olofos/humidity/humidity.ods

Sheet: Power
 | Sleep | Measure | Transmit | Receive | Total
STM32L031F6P6 @ 16MHz | 0.02 | 4.8 | 4.8 | 4.8
RFM69HW | 0.005 | 0.005 | 50 | 16
SHTC3 | 0.001 | 0.9 | 0.001 | 0.001
 | 0.026 | 5.705 | 54.801 | 20.801
Time (s/h) | 3565 | 15 | 10 | 10 | 3600
mAs/h | 92.69 | 85.575 | 548.01 | 208.01
mAh/h | 0.025747222222222 | 0.023770833333333 | 0.152225 | 0.057780555555556 | 0.259523611111111
Battery (mAh) |  |  |  |  | 600
Runtime (y) |  |  |  |  | 0.263918764044968

Sheet: Pins
 | Function | Signal | TQFP32
VDD |  |  | 1
PC14 | OSC32_IN |  | 2
PC15 | OSC32_OUT |  | 3
NRST |  |  | 4
VDDA |  |  | 5
PA0-CK_IN |  | LEDR | 6
PA1 |  | LEDH | 7
PA2 | USART2_TX |  | 8
PA3 | USART2_RX |  | 9
PA4 | ADC | BAT_MID | 10
PA5 | SPI1_SCK |  | 11
PA6 | SPI1_MSIO |  | 12
PA7 | SPI1_MISO |  | 13
PB0 |  | CS_RFM | 14
PB1 |  | CS_FLASH | 15
VSS |  |  | 16
VDD |  |  | 17
PA8 |  | RFM69_INT | 18
PA9 | I2C1_SCL |  | 19
PA10 | I2C1_SDA |  | 20
PA11 |  | - | 21
PA12 |  | - | 22
PA13 | SWDIO |  | 23
PA14 | SWCLK |  | 24
PA15 |  | - | 25
PB3 |  | CONF0 | 26
PB4 |  | CONF1 | 27
PB5 |  | CONF2 | 28
PB6 |  | CONF3 | 29
PB7 |  | CONF4 | 30
BOOT0 |  |  | 31
VSS |  |  | 32

Sheet: BOM
Node
 | Qty | Reference(s) | Value | TME Link | TME Price | Sum |  | 5
 | 7 | C1, C2, C3, C4, C6, C7, C14 | 100n | https://www.tme.eu/se/en/details/cl10b104ko8nnnc/0603-mlcc-smd-capacitors/samsung/ | 0.13310 | 0.93 | x | 35
 | 2 | C5, C15 | 22u | https://www.tme.eu/se/en/details/sc1e226m05005vr/85degc-smd-electrolytic-capacitors/samwha/ | 0.36794 | 0.74 | x | 10 | https://www.tme.eu/se/en/details/uwx1c220mcl1gb/85degc-smd-electrolytic-capacitors/nichicon/
 | 2 | C12, C13 | 18p | https://www.tme.eu/se/en/details/vj0603a180jxacw2bc/0603-mlcc-smd-capacitors/vishay/ | 0.13033 | 0.26 | x | 10
 | 1 | D1 | KP-2012LSURCK | https://www.tme.eu/se/en/details/kp-2012lsurck/smd-colour-leds/kingbright-electronic/ | 1.02540 | 1.03 | x | 5
 | 1 | D2 | KP-2012LSGC | https://www.tme.eu/se/en/details/kp-2012lsgc/smd-colour-leds/kingbright-electronic/ | 1.05200 | 1.05 | x | 5
 | 1 | D3 | 1N4148W | https://www.tme.eu/se/en/details/1n4148w-7-f/smd-universal-diodes/diodes-incorporated/ | 0.24810 | 0.25 | x | 5
 | 1 | J1 | BOOT0_Jumper |  |  | 0.00 |  | 5
 | 1 | J2 | FTDI |  |  | 0.00 |  | 5
 | 1 | J3 | SMA Female | https://www.tme.eu/se/en/details/rf2-03e-t-00-50-g/sma-smb-smc-connectors/adam-tech/ | 12.76000 | 12.76 | x | 5
 | 1 | J4 | 2 x AA | https://www.tme.eu/se/en/details/zl262-3sg/pin-headers/connfly/ds1023-1-3s21/ | 0.60822 | 0.61 | x | 5
 | 1 | J5 | SWD |  |  | 0.00 |  | 5
 | 1 | Q1 | Si2323DDS | https://www.tme.eu/se/en/details/si2323dds-t1-ge3/smd-p-channel-transistors/vishay/ | 3.34344 | 3.34 | x | 5
 | 5 | R1, R2, R3, R4, R5 | 0 | https://www.tme.eu/se/en/details/smd0603-0r/0603-smd-resistors/royal-ohm/0603saj0000t5e/ | 0.09735 | 0.49 | x | 25
 | 2 | R11, R12 | DNP | - |  | 0.00 |  | 10
 | 3 | R13, R32, R33 | 10k | https://www.tme.eu/se/en/details/crcw060310k0fktabc/0603-smd-resistors/vishay/ | 0.12458 | 0.37 | x | 15
 | 3 | R14, R16, R30 | 330R | https://www.tme.eu/se/en/details/smd0603-330r-1%25/0603-smd-resistors/royal-ohm/0603saf3300t5e/ | 0.11531 | 0.35 | x | 15
 | 5 | R17, R20, R21, R25, R34 | 100k | https://www.tme.eu/se/en/details/cq0603-100k-1%25/0603-smd-resistors/royal-ohm/cq03saf1003t5e/ | 0.18525 | 0.93 | x | 25
 | 2 | R18, R19 | 4k7 | https://www.tme.eu/se/en/details/smd0603-4k7-1%25/0603-smd-resistors/royal-ohm/0603saf4701t5e/ | 0.11513 | 0.23 | x | 10
 | 1 | R31 | 240R | https://www.tme.eu/se/en/details/smd0603-240r-1%25/0603-smd-resistors/royal-ohm/0603saf0241t5e/ | 0.11531 | 0.12 | x | 5
 | 1 | SW1 | DTSM-65R-V-B | https://www.tme.eu/se/en/details/dtsm-65r-v-b/microswitches-tact/diptronics/ | 1.88940 | 1.89 | x | 5
 | 1 | U1 | RFM69HW | https://www.tme.eu/se/en/details/rfm69hw-433s2/rf-modules/hope-microelectronics/ | 29.96000 | 29.96 | x | 5
 | 1 | U2 | SHTC3 | https://www.tme.eu/se/en/details/shtc3/humidity-sensors/sensirion/3-000-047/ | 16.93000 | 16.93 | x | 5
 | 1 | U3 | AT25DF512C | https://www.tme.eu/se/en/details/at25df512c-sshngub/serial-flash-memories-integrated-circ/adesto/at25df512c-sshngu-b/ | 4.54000 | 4.54 | x | 5
 | 1 | U4 | STM32L031K6T6 | https://www.tme.eu/se/en/details/stm32l031k6t6/st-microcontrollers/st-microelectronics/ | 20.98000 | 20.98 | x | 5
 | 1 | Y1 | 32.768K | https://www.tme.eu/se/en/details/26-hx5f-32.768k/tht-quartz-crystals/ilsi/26-hx5f12-5-32-768khz/ | 1.52097 | 1.52 | x | 5
 |  |  |  |  | Total | 99.26
Node Batteries
 | Qty | Reference(s) | Value | TME Link | TME Price | Sum
 | 2 | BT1, BT2 | Battery_Cell | https://www.tme.eu/se/en/details/bh-311-1p/batteries-holders/comf/ | 2.56888 | 5.14 | x | 10
 | 1 | J1 | Conn_01x03_Male | https://www.tme.eu/se/en/details/zl201-03g/pin-headers/connfly/ds1021-1-3sf1-1/ | 0.22041 | 0.22 | x | 5
 |  |  |  |  | Total | 5.35817
Case
 | 1 | Antenna | 433M-ANT402 | https://www.tme.eu/se/en/details/433m-ant402/rf-antennas/sr-passives/ | 22.12000 | 22.12 | x
 | 4 | Standoff M3 6mm | TFM-M3X6/DR214 | https://www.tme.eu/se/en/details/tfm-m3x6_dr214/metal-spacers/dremec/214x06/ | 2.85150 | 11.41
 | 4 | Standoff M3 12mm | TFM-M3X12/DR224 | https://www.tme.eu/se/en/details/tfm-m3x12_dr224/metal-spacers/dremec/224x12/ | 2.24350 | 8.97
 | 4 | Standoff M3 15mm | TFM-M3X15/DR224 | https://www.tme.eu/se/en/details/tfm-m3x15_dr224/metal-spacers/dremec/224x15/ | 1.80060 | 7.20
 | 2 | Standoff M3 20mm | TFM-M3X20/DR224 | https://www.tme.eu/se/en/details/tfm-m3x20_dr224/metal-spacers/dremec/224x20/ | 2.50120 | 5.00
 | 2 | Screw M3 8mm | M3X8/D912-A2 | https://www.tme.eu/se/en/details/m3x8_d912-a2/bolts/kraftberg/ | 0.13100 | 0.26
 | 4 | Washer M3 7mm 0.5mm | K3.2/D125-A2 | https://www.tme.eu/se/en/details/k3.2_d125-a2/washers/kraftberg/ | 0.04880 | 0.20
 | 6 | Nut M3 | B3/BN117 | https://www.tme.eu/se/en/details/b3_bn117/nuts/bossard/1874659/ | 0.05111 | 0.31
 | 4 | Foot M3 | RI-TB-3 | https://www.tme.eu/se/en/details/ri-tb-3/feet/richco/tb-3/ | 4.80580 | 19.22
 |  |  |  |  | Total | 74.69
 |  |  |  |  | Sum Total | 179.31
Gateway
 | Qty | Reference(s) | Value | TME Link | TME Price
 | 1 | BT1 | KEYS3000 | https://www.tme.eu/se/en/details/keys3000/batteries-holders/keystone/3000/ | 4.2504 | 4.25 | x
 | 2 | C1, C4 | 22u | https://www.tme.eu/se/en/details/sc1e226m05005vr/85degc-smd-electrolytic-capacitors/samwha/ | 0.36794 | 0.74 | x
 | 2 | C2, C3 | 100n | https://www.tme.eu/se/en/details/cl10b104ko8nnnc/0603-mlcc-smd-capacitors/samsung/ | 0.1331 | 0.27 | x
 | 1 | C6 | 1u |  |  | 0.00
 | 1 | D1 | KP-2012LSURCK | https://www.tme.eu/se/en/details/kp-2012lsurck/smd-colour-leds/kingbright-electronic/ | 1.052 | 1.05 | x
 | 1 | D2 | KP-2012LSGC | https://www.tme.eu/se/en/details/kp-2012lsgc/smd-colour-leds/kingbright-electronic/ | 0.2481 | 0.25 | x
 | 4 | H1, H2, H3, H4 | MountingHole |  |  | 0.00
 | 1 | J1 | FTDI |  |  | 0.00
 | 1 | J2 | Conn_Coaxial | https://www.tme.eu/se/en/details/rf2-19a-t-00-50-g/sma-smb-smc-connectors/adam-tech/ | 10.86 | 10.86 | x
 | 1 | J3 | Raspberry_Pi_2_3 | https://www.tme.eu/se/en/details/zl264-40dg/pin-headers/ninigi/ | 24.27 | 24.27 | x | https://www.tme.eu/se/en/details/zl301-2x20p/pin-headers/ninigi/
 | 4 | R1, R4, R12, R13 | DNP |  |  | 0.00
 | 2 | R2, R3 | 0 | https://www.tme.eu/se/en/details/smd0603-0r/0603-smd-resistors/royal-ohm/0603saj0000t5e/ | 0.09735 | 0.19 | x
 | 2 | R5, R6 | 10k | https://www.tme.eu/se/en/details/crcw060310k0fktabc/0603-smd-resistors/vishay/ | 0.12458 | 0.25 | x
 | 2 | R8, R11 | 330R | https://www.tme.eu/se/en/details/smd0603-330r-1%25/0603-smd-resistors/royal-ohm/0603saf3300t5e/ | 0.11531 | 0.23 | x
 | 1 | U1 | RFM69HW | https://www.tme.eu/se/en/details/rfm69hw-433s2/rf-modules/hope-microelectronics/ | 29.94 | 29.94 | x
 | 1 | U2 | DS1307Z+ | https://www.tme.eu/se/en/details/ds1307z+/rtc-circuits/maxim-integrated/ | 15.02 | 15.02 | x
 | 1 | U3 | AP130-xxY | https://www.tme.eu/se/en/details/ap130-33yg-13/ldo-unregulated-voltage-regulators/diodes-incorporated/ | 2.47293 | 2.47 | x
 | 1 | Y1 | 32768 | https://www.tme.eu/se/en/details/26-hx5f-32.768k/tht-quartz-crystals/ilsi/26-hx5f12-5-32-768khz/ | 1.52097 | 1.52 | x
 |  |  |  |  | Total | 91.31
