olofos/humidity/hardware/gateway/gateway.kicad_pcb

## KiCad design hardware/gateway/gateway.kicad_pcb (2019-08-25)

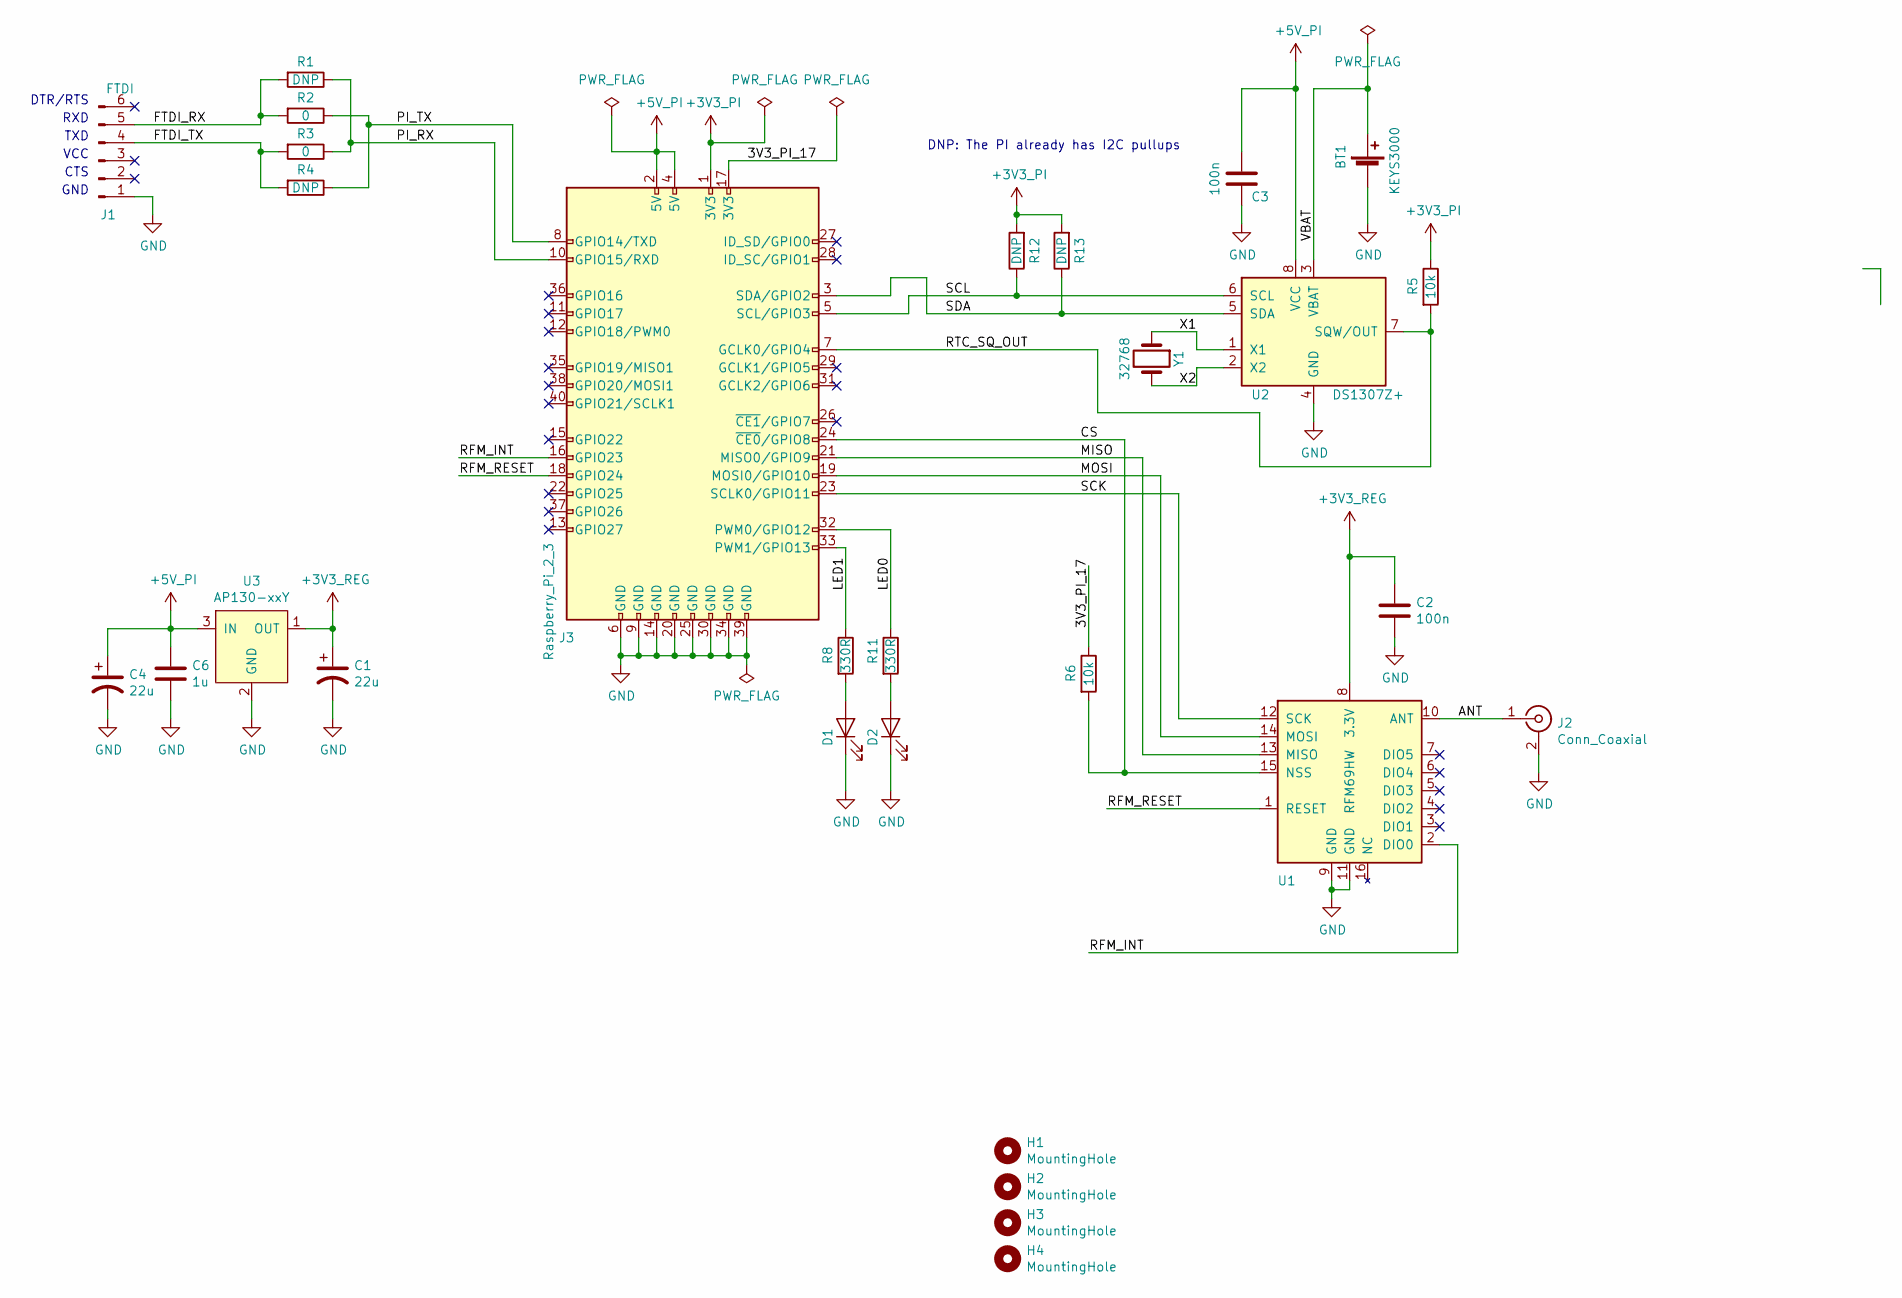
[picture p1: schematic gateway.sch]

Parts:
BT1: KEYS3000; CR1216_Keystone_3000
C1, C4: 22u; CP_Elec_5x5.3
C2, C3: 100n; C_0603_1608Metric_Pad1.05x0.95mm_HandSolder
C6: 1u; C_0805_2012Metric_Pad1.15x1.40mm_HandSolder
D1: KP-2012LSURCK; LED_0805_2012Metric_Pad1.15x1.40mm_HandSolder
D2: KP-2012LSGC; LED_0805_2012Metric_Pad1.15x1.40mm_HandSolder
H1, H2, H3, H4: MountingHole; MountingHole_2.7mm_M2.5
J1: FTDI; PinHeader_1x06_P2.54mm_Horizontal
J2: Conn_Coaxial; Adam_Tech_SMA_Female_RF2-19A
J3: Raspberry_Pi_2_3; PinSocket_2x20_P2.54mm_Vertical_SMD
R1, R4, R12, R13: DNP; R_0603_1608Metric_Pad1.05x0.95mm_HandSolder-DNP
R2, R3: 0; R_0603_1608Metric_Pad1.05x0.95mm_HandSolder
R5, R6: 10k; R_0603_1608Metric_Pad1.05x0.95mm_HandSolder
R8, R11: 330R; R_0603_1608Metric_Pad1.05x0.95mm_HandSolder
U1: RFM69HW
U2: DS1307Z+; SOIC-8_3.9x4.9mm_P1.27mm
U3: AP130-xxY; SOT-89-3_Handsoldering
Y1: 32768; Crystal_C26-LF_D2.1mm_L6.5mm_Horizontal

Connections:
+3V3_PI: J3.1 (3V3), R5.1, R12.2, R13.2
+3V3_REG: C1.1, C2.1, U1.8 (3.3V), U3.1 (OUT)
+5V_PI: C3.1, C4.1, C6.1, J3.2 (5V), J3.4 (5V), U2.8 (VCC), U3.3 (IN)
/3V3_PI_17: J3.17 (3V3), R6.1
/ANT: J2.1 (In), U1.10 (ANT)
/CS: J3.24 (~CE0~/GPIO8), R6.2, U1.15 (NSS)
/FTDI_RX: J1.5, R1.2, R2.2
/FTDI_TX: J1.4, R3.2, R4.2
/LED0: J3.32 (PWM0/GPIO12), R11.1
/LED1: J3.33 (PWM1/GPIO13), R8.1
/MISO: J3.21 (MISO0/GPIO9), U1.13 (MISO)
/MOSI: J3.19 (MOSI0/GPIO10), U1.14 (MOSI)
/PI_RX: J3.10 (GPIO15/RXD), R1.1, R3.1
/PI_TX: J3.8 (GPIO14/TXD), R2.1, R4.1
/RFM_INT: J3.16 (GPIO23), U1.2 (DIO0)
/RFM_RESET: J3.18 (GPIO24), U1.1 (RESET)
/RTC_SQ_OUT: J3.7 (GCLK0/GPIO4), R5.2, U2.7 (SQW/OUT)
/SCK: J3.23 (SCLK0/GPIO11), U1.12 (SCK)
/SCL: J3.5 (SCL/GPIO3), R12.1, U2.6 (SCL)
/SDA: J3.3 (SDA/GPIO2), R13.1, U2.5 (SDA)
/VBAT: BT1.1 (+), U2.3 (VBAT)
/X1: U2.1 (X1), Y1.1
/X2: U2.2 (X2), Y1.2
GND: BT1.2 (-), C1.2, C2.2, C3.2, C4.2, C6.2, D1.1 (K), D2.1 (K), J1.1, J2.2 (Ext), J3.6 (GND), J3.9 (GND), J3.14 (GND), J3.20 (GND), J3.25 (GND), J3.30 (GND), J3.34 (GND), J3.39 (GND), U1.9 (GND), U1.11 (GND), U2.4 (GND), U3.2 (GND)
unnamed: D1.2 (A), R8.2
unnamed: D2.2 (A), R11.2

Notes on the sheet:
GND
CTS
VCC
TXD
RXD
DTR/RTS
DNP: The PI already has I2C pullups

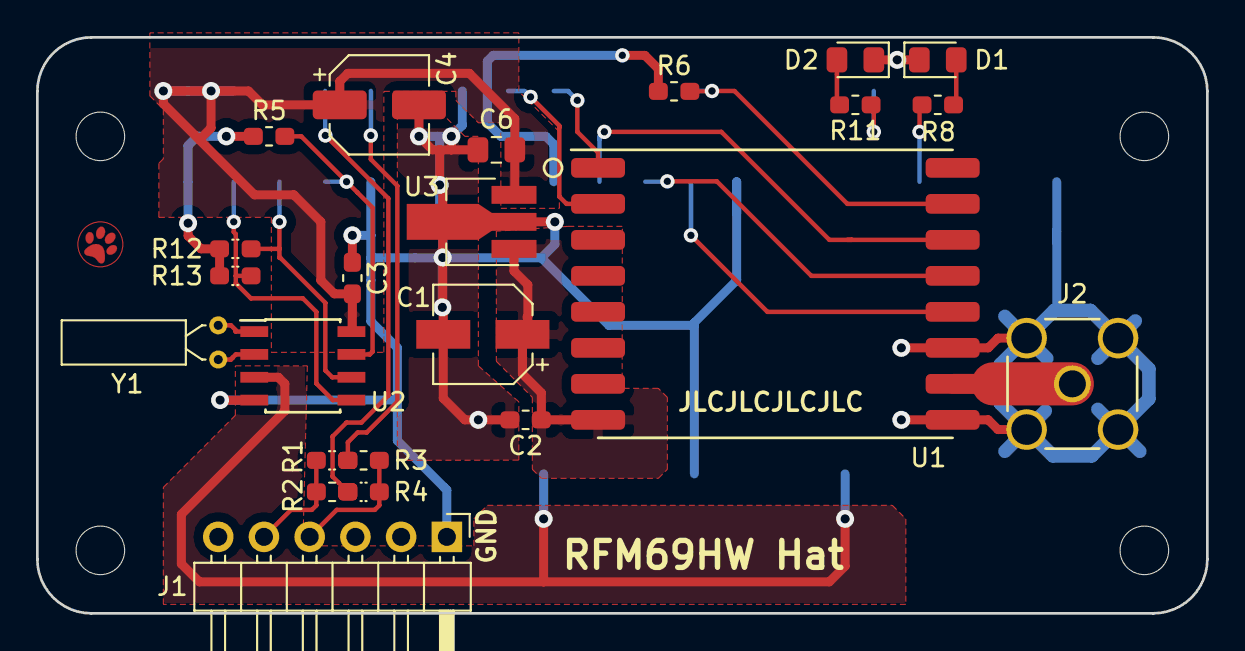
[picture p2: board gateway.kicad_pcb from above]

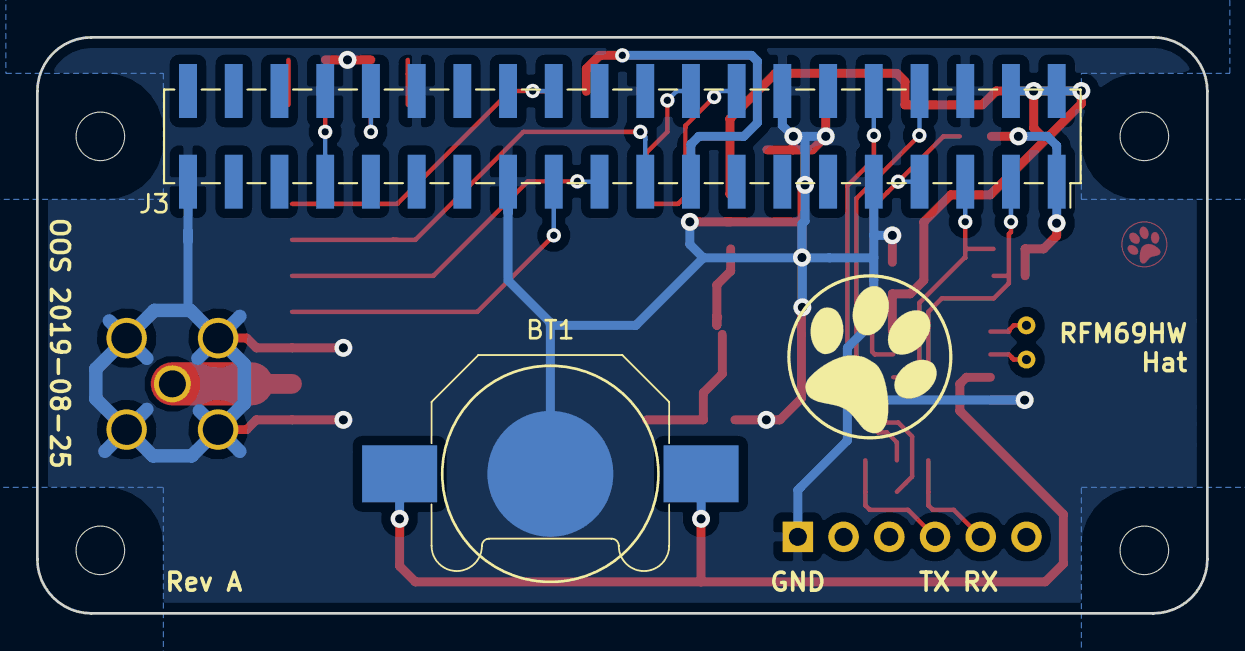
[picture p3: board gateway.kicad_pcb from below]

Board: 2 copper layers, 65.0 x 32.0 mm, 29 parts (2 on the bottom side), 26 nets.
