olofos/humidity/hardware/node/node.kicad_pcb

## KiCad design hardware/node/node.kicad_pcb (2019-08-25)

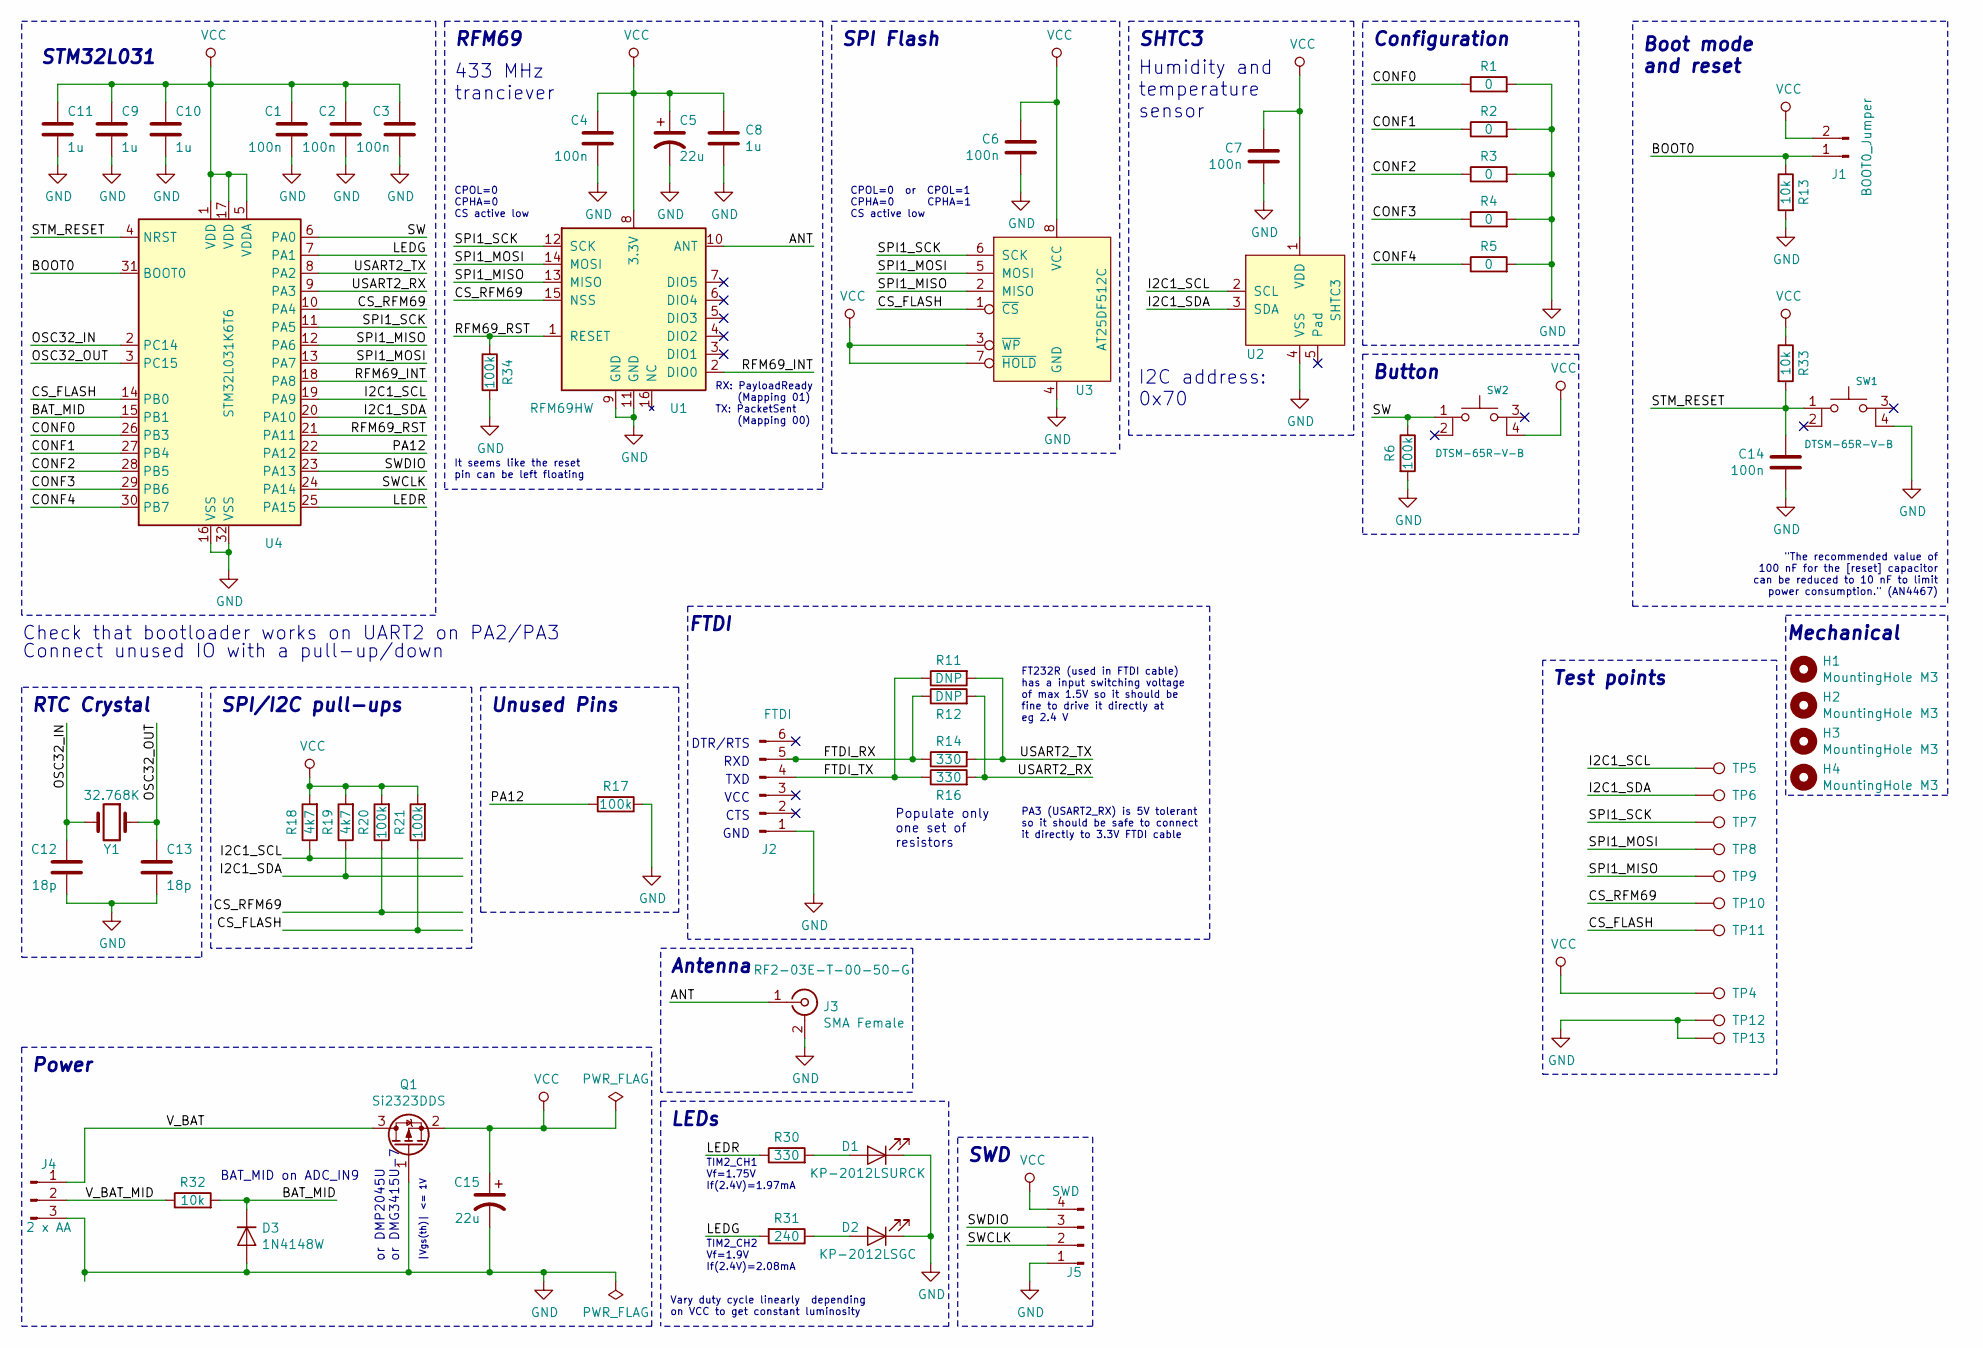
[picture p4: schematic node.sch, Humidity sensor node wih 433 MHz RFM69 tranceiver]

Parts:
C1, C2, C3, C4, C6, C7, C14: 100n; C_0603_1608Metric_Pad1.05x0.95mm_HandSolder
C5, C15: 22u; CP_Elec_5x5.3
C8, C9, C10, C11: 1u; C_0805_2012Metric_Pad1.15x1.40mm_HandSolder
C12, C13: 18p; C_0603_1608Metric_Pad1.05x0.95mm_HandSolder
D1: KP-2012LSURCK; LED_0805_2012Metric_Pad1.15x1.40mm_HandSolder
D2: KP-2012LSGC; LED_0805_2012Metric_Pad1.15x1.40mm_HandSolder
D3: 1N4148W; D_SOD-123
H1, H2, H3, H4: MountingHole M3; MountingHole_3.2mm_M3
J1: BOOT0_Jumper; PinHeader_1x02_P2.54mm_Vertical
J2: FTDI; PinHeader_1x06_P2.54mm_Horizontal
J3: SMA Female; Adam_Tech_SMA_Female_RF2-19A; Part RF2-03E-T-00-50-G
J4: 2 x AA; PinHeader_1x03_P2.54mm_Vertical
J5: SWD; PinHeader_1x04_P2.54mm_Horizontal
Q1: Si2323DDS; SOT-23_Handsoldering
R1, R2, R3, R4, R5: 0; R_0603_1608Metric_Pad1.05x0.95mm_HandSolder
R6, R17, R20, R21, R34: 100k; R_0603_1608Metric_Pad1.05x0.95mm_HandSolder
R11, R12: DNP; R_0603_1608Metric_Pad1.05x0.95mm_HandSolder-DNP
R13, R32, R33: 10k; R_0603_1608Metric_Pad1.05x0.95mm_HandSolder
R14, R16, R30: 330; R_0603_1608Metric_Pad1.05x0.95mm_HandSolder
R18, R19: 4k7; R_0603_1608Metric_Pad1.05x0.95mm_HandSolder
R31: 240; R_0603_1608Metric_Pad1.05x0.95mm_HandSolder
SW1, SW2: DTSM-65R-V-B; SW_SPST_DTSM-6
TP4, TP5, TP6, TP7, TP8, TP9, TP10, TP11: TestPoint; TestPoint_THTPad_D1.5mm_Drill0.7mm
TP12, TP13: TestPoint; TestPoint_THTPad_1.5x1.5mm_Drill0.7mm
U1: RFM69HW
U2: SHTC3
U3: AT25DF512C; SOIC-8_3.9x4.9mm_P1.27mm
U4: STM32L031K6T6; LQFP-32_7x7mm_P0.8mm
Y1: 32.768K; Crystal_C26-LF_D2.1mm_L6.5mm_Horizontal

Connections:
/ANT: J3.1 (In), U1.10 (ANT)
/BAT_MID: D3.1 (K), R32.2, U4.15 (PB1)
/BOOT0: J1.1, R13.1, U4.31 (BOOT0)
/CONF0: R1.1, U4.26 (PB3)
/CONF1: R2.1, U4.27 (PB4)
/CONF2: R3.1, U4.28 (PB5)
/CONF3: R4.1, U4.29 (PB6)
/CONF4: R5.1, U4.30 (PB7)
/CS_FLASH: R21.1, TP11.1, U3.1 (~CS), U4.14 (PB0)
/CS_RFM69: R20.1, TP10.1, U1.15 (NSS), U4.10 (PA4)
/FTDI_RX: J2.5, R12.1, R14.1
/FTDI_TX: J2.4, R11.1, R16.1
/I2C1_SCL: R18.1, TP5.1, U2.2 (SCL), U4.19 (PA9)
/I2C1_SDA: R19.1, TP6.1, U2.3 (SDA), U4.20 (PA10)
/LEDG: R31.2, U4.7 (PA1)
/LEDR: R30.1, U4.25 (PA15)
/OSC32_IN: C12.2, U4.2 (PC14), Y1.2
/OSC32_OUT: C13.1, U4.3 (PC15), Y1.1
/PA12: R17.2, U4.22 (PA12)
/RFM69_INT: U1.2 (DIO0), U4.18 (PA8)
/RFM69_RST: R34.1, U1.1 (RESET), U4.21 (PA11)
/SPI1_MISO: TP9.1, U1.13 (MISO), U3.2 (MISO), U4.12 (PA6)
/SPI1_MOSI: TP8.1, U1.14 (MOSI), U3.5 (MOSI), U4.13 (PA7)
/SPI1_SCK: TP7.1, U1.12 (SCK), U3.6 (SCK), U4.11 (PA5)
/STM_RESET: C14.2, R33.2, SW1.1, U4.4 (NRST)
/SW: R6.1, SW2.1, U4.6 (PA0)
/SWCLK: J5.2, U4.24 (PA14)
/SWDIO: J5.3, U4.23 (PA13)
/USART2_RX: R12.2, R16.2, U4.9 (PA3)
/USART2_TX: R11.2, R14.2, U4.8 (PA2)
/V_BAT: J4.1, Q1.3 (D)
/V_BAT_MID: J4.2, R32.1
GND: C1.1, C2.1, C3.1, C4.1, C5.2, C6.1, C7.1, C8.2, C9.2, C10.2, C11.2, C12.1, C13.2, C14.1, C15.2, D1.1 (K), D2.1 (K), D3.2 (A), J2.1, J3.2 (Ext), J4.3, J5.1, Q1.1 (G), R1.2, R2.2, R3.2, R4.2, R5.2, R6.2, R13.2, R17.1, R34.2, SW1.4, TP12.1, TP13.1, U1.9 (GND), U1.11 (GND), U2.4 (VSS), U3.4 (GND), U4.16 (VSS), U4.32 (VSS)
unnamed: D1.2 (A), R30.2
unnamed: D2.2 (A), R31.1
VCC: C1.2, C2.2, C3.2, C4.2, C5.1, C6.2, C7.2, C8.1, C9.1, C10.1, C11.1, C15.1, J1.2, J5.4, Q1.2 (S), R18.2, R19.2, R20.2, R21.2, R33.1, SW2.4, TP4.1, U1.8 (3.3V), U2.1 (VDD), U3.3 (~WP), U3.7 (~HOLD), U3.8 (VCC), U4.1 (VDD), U4.5 (VDDA), U4.17 (VDD)

Notes on the sheet:
GND
CTS
VCC
TXD
RXD
DTR/RTS
Populate only one set of resistors
RTC Crystal
Power
Configuration
SPI/I2C pull-ups
SWD
FTDI
Boot mode and reset
LEDs
SHTC3
Humidity and temperature sensor
I2C address: 0x70
SPI Flash
RFM69
433 MHz tranciever
STM32L031
Check that bootloader works on UART2 on PA2/PA3
Connect unused IO with a pull-up/down
or DMP2045U or DMG3415U-7
|Vgs(th)| <= 1V
RX: PayloadReady (Mapping 01) TX: PacketSent (Mapping 00)
Antenna
Unused Pins
CPOL=0 CPHA=0 CS active low
CPOL=0 or CPOL=1 CPHA=0 CPHA=1 CS active low
TIM2_CH1 Vf=1.75V If(2.4V)=1.97mA
TIM2_CH2 Vf=1.9V If(2.4V)=2.08mA
PA3 (USART2_RX) is 5V tolerant so it should be safe to connect it directly to 3.3V FTDI cable
FT232R (used in FTDI cable) has a input switching voltage of max 1.5V so it should be fine to drive it directly at eg 2.4 V
It seems like the reset pin can be left floating
Vary duty cycle linearly depending on VCC to get constant luminosity
"The recommended value of 100 nF for the [reset] capacitor can be reduced to 10 nF to limit power consumption." (AN4467)
Mechanical
BAT_MID on ADC_IN9
Test points
Button

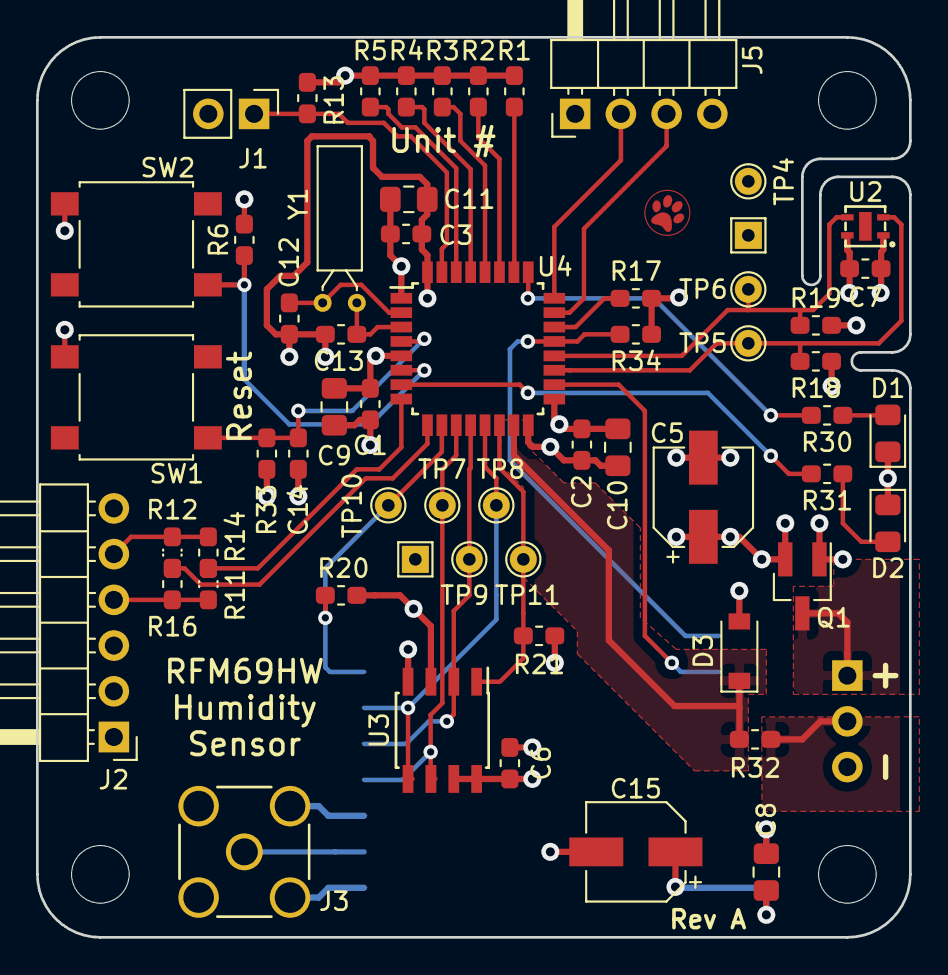
[picture p5: board node.kicad_pcb from above]

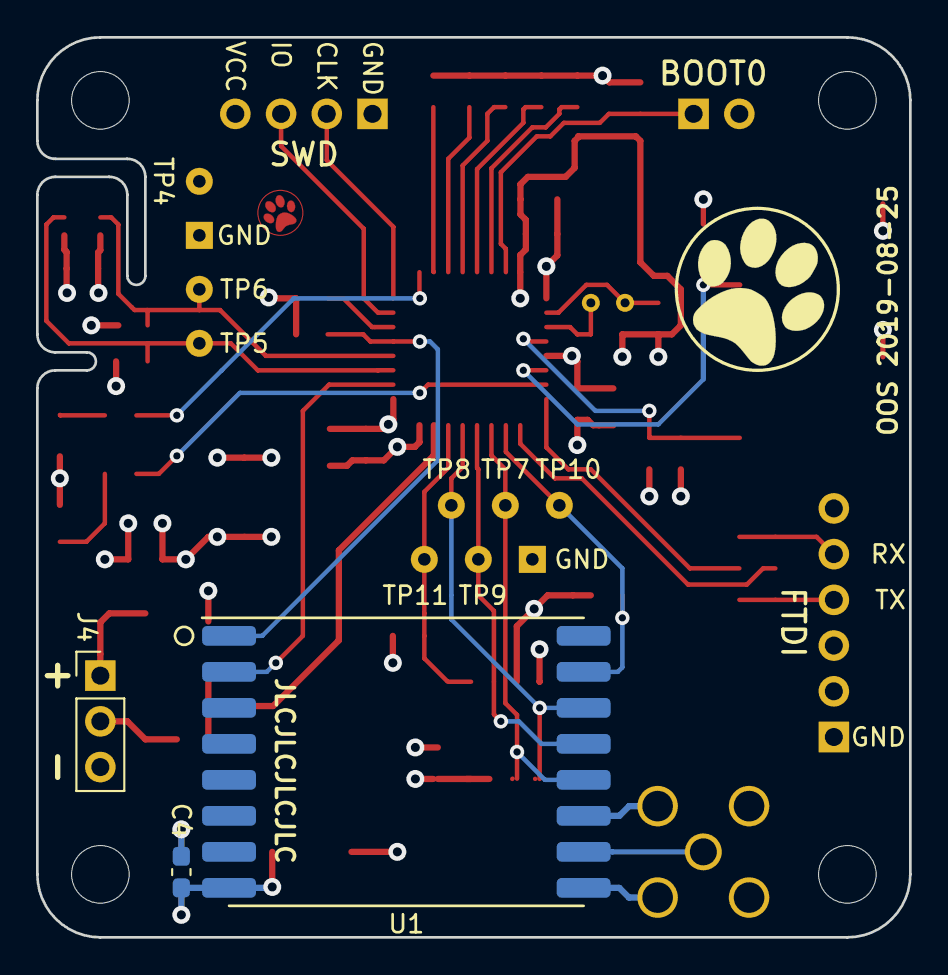
[picture p6: board node.kicad_pcb from below]

Board: 4 copper layers, 48.5 x 50.0 mm, 66 parts (3 on the bottom side), 36 nets.
