olofos/humidity/hardware/node-batteries/node-batteries.kicad_pcb

## KiCad design hardware/node-batteries/node-batteries.kicad_pcb (2019-08-25)

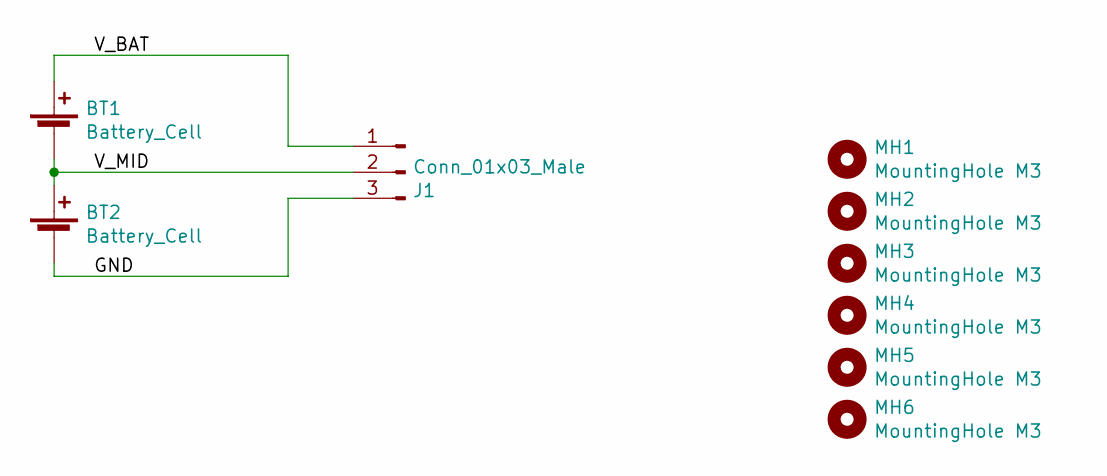
[picture p7: schematic node-batteries.sch]

Parts:
BT1, BT2: Battery_Cell; AA_Battery_Holder
J1: Conn_01x03_Male; PinSocket_1x03_P2.54mm_Vertical
MH1, MH2, MH3, MH4, MH5, MH6: MountingHole M3; MountingHole_3.2mm_M3

Connections:
/GND: BT2.2 (-), J1.3
/V_BAT: BT1.1 (+), J1.1
/V_MID: BT1.2 (-), BT2.1 (+), J1.2

Board: 2 copper layers, 9 parts (2 on the bottom side), 3 nets, no tracks yet.
