olofos/humidity/cube/cube.ioc

Mcu.UserName=STM32L031K6Tx
PA0-CK_IN.GPIO_Label=TIM2_CH1_LED0
PA0-CK_IN.Signal=S_TIM2_CH1
PA1.GPIO_Label=TIM2_CH2_LED1
PA1.Signal=S_TIM2_CH2
PA10.Signal=I2C1_SDA
PA13.Signal=SYS_SWDIO
PA14.Signal=SYS_SWCLK
PA2.Signal=LPUART1_TX
PA3.Signal=LPUART1_RX
PA4.Signal=ADC_IN4
PA5.Signal=SPI1_SCK
PA6.Signal=SPI1_MISO
PA7.Signal=SPI1_MOSI
PA8.GPIO_Label=RFM69_INT
PA8.Signal=GPIO_Input
PA9.Signal=I2C1_SCL
PB0.GPIO_Label=SPI_CS_RFM69
PB0.Signal=GPIO_Output
PB1.GPIO_Label=SPI_CS_FLASH
PB1.Signal=GPIO_Output
PB3.GPIO_Label=CONF0
PB3.Signal=GPIO_Input
PB4.GPIO_Label=CONF1
PB4.Signal=GPIO_Input
PB5.GPIO_Label=CONF2
PB5.Signal=GPIO_Input
PB6.GPIO_Label=CONF3
PB6.Signal=GPIO_Input
PB7.GPIO_Label=CONF4
PB7.Signal=GPIO_Input
PC14-OSC32_IN.Signal=RCC_OSC32_IN
PC15-OSC32_OUT.Signal=RCC_OSC32_OUT
