olofos/humidity/software/node/include/version.h

#ifndef VERSION_H_
#define VERSION_H_

#define VERSION_MAJOR 0x00
#define VERSION_MINOR 0x02
#define VERSION_PATCH 0x0001

extern const char firmware_git_version[24];
extern const uint32_t firmware_version;
extern uint32_t firmware_crc;


#endif
