olofos/humidity/software/node/src/rtc.c

#include "stm32l0xx.h"
#include "rtc.h"
#include "vector.h"
#include "systick.h"
#include "package-protocol.h"

#define RTC_UNLOCK_MAGIC1 0xCA
#define RTC_UNLOCK_MAGIC2 0x53

#define RTC_LOCK_MAGIC    0xFF

#define RTC_EXTI (1 << 20)

static void rtc_write_protect_unlock(void)
{
    RTC->WPR = RTC_UNLOCK_MAGIC1;
    RTC->WPR = RTC_UNLOCK_MAGIC2;
}

static void rtc_write_protect_lock(void)
{
    RTC->WPR = RTC_LOCK_MAGIC;
}

int rtc_is_rtc_clock_initialized(void)
{
    return RTC->ISR & RTC_ISR_INITS;
}

void rtc_set_time(const struct pkg_timestamp *pkg_timestamp)
{
    uint32_t time = ((uint32_t) pkg_timestamp->hour << 16) | ((uint32_t) pkg_timestamp->minute << 8) | pkg_timestamp->second;
    uint32_t date = ((uint32_t) pkg_timestamp->year << 16) | ((uint32_t) pkg_timestamp->month << 8) | pkg_timestamp->day;

    rtc_write_protect_unlock();

    RTC->ISR |= RTC_ISR_INIT;

    while(!(RTC->ISR & RTC_ISR_INITF)) {
    }

    RTC->TR = time;
    RTC->DR = date;

    RTC->ISR &= ~RTC_ISR_INIT;

    rtc_write_protect_lock();
}

void rtc_get_time(struct pkg_timestamp *pkg_timestamp)
{
    while(!(RTC->ISR & RTC_ISR_RSF)) {
    }

    uint32_t time = RTC->TR & 0x003F7F7F;
    uint32_t date = RTC->DR & 0x00FF1F3F;

    pkg_timestamp->year = (date >> 16) & 0x000000FF;
    pkg_timestamp->month = (date >> 8) & 0x000000FF;
    pkg_timestamp->day = date & 0x000000FF;

    pkg_timestamp->hour = (time >> 16) & 0x000000FF;
    pkg_timestamp->minute = (time >> 8) & 0x000000FF;
    pkg_timestamp->second = time & 0x000000FF;
}

void rtc_set_periodic_wakeup(uint16_t seconds)
{
    rtc_write_protect_unlock();

    RTC->CR &= ~RTC_CR_WUTE;

    while(!(RTC->ISR & RTC_ISR_WUTWF)) {
    }

    RTC->CR = (RTC->CR & ~(RTC_CR_WUCKSEL_Msk)) | (0x04 << RTC_CR_WUCKSEL_Pos) | RTC_CR_WUTIE;
    RTC->WUTR = seconds - 1;

    RTC->CR |= RTC_CR_WUTE;

    rtc_write_protect_lock();

    EXTI->IMR |= RTC_EXTI;
    EXTI->RTSR |= RTC_EXTI;

    NVIC_EnableIRQ(RTC_IRQn);

    RTC->ISR = 0;
}

void RTC_IRQHandler(void)
{
    EXTI->PR = RTC_EXTI;
}
