olofos/humidity/software/common/include/rfm69-config.h

#ifndef RFM69_CONFIG_H_
#define RFM69_CONFIG_H_

#define RFM69_BIT_RATE 250000UL
#define RFM69_FDEV     250000UL
#define RFM69_FREQUENCY 433500000UL

#define RFM69_SYNC_WORD { 0x52, 0x71, 0x4b, 0x27 }
#define RFM69_PREAMBLE_LEN 8

#endif
