olofos/humidity/software/node/include/spi-flash.h

#ifndef SPI_FLASH_H_
#define SPI_FLASH_H_

#define SPI_FLASH_PAGE_SIZE 256

int spi_flash_test(void);

void spi_flash_erase_page(uint32_t address);
void spi_flash_write_page(uint32_t address, uint8_t *buf, uint16_t length);
void spi_flash_read(uint32_t address, uint8_t *buf, uint32_t length);
uint32_t spi_flash_read_id(void);

void spi_flash_sleep(void);
void spi_flash_wakeup(void);

#endif
