olofos/humidity/software/node/include/vector.h

#ifndef VECTOR_H_
#define VECTOR_H_

void Default_Handler(void);
void Reset_Handler(void);
void NMI_Handler(void);
void HardFault_Handler(void);
void SVC_Handler(void);
void PendSV_Handler(void);
void SysTick_Handler(void);

void WWDG_IRQHandler(void);
void PVD_IRQHandler(void);
void RTC_IRQHandler(void);
void FLASH_IRQHandler(void);
void RCC_IRQHandler(void);
void EXTI0_1_IRQHandler(void);
void EXTI2_3_IRQHandler(void);
void EXTI4_15_IRQHandler(void);
void DMA1_Channel1_IRQHandler(void);
void DMA1_Channel2_3_IRQHandler(void);
void DMA1_Channel4_5_6_7_IRQHandler(void);
void ADC1_COMP_IRQHandler(void);
void LPTIM1_IRQHandler(void);
void TIM2_IRQHandler(void);
void TIM21_IRQHandler(void);
void TIM22_IRQHandler(void);
void I2C1_IRQHandler(void);
void SPI1_IRQHandler(void);
void USART2_IRQHandler(void);
void LPUART1_IRQHandler(void);

int main(void);

#endif
