olofos/humidity/(commit log)

2019-05-23 Initial commit with some basic design documents
    [humidity.ods]
2019-05-23 Initial node schematic
    [node.kicad_pcb, node.sch]
2019-05-23 Removed UART level translation
    [node.sch]
2019-05-23 Added 4 x M3 mounting holes
    [node.sch]
2019-05-23 PCB mount battery holders
    [node.kicad_pcb, node.sch]
2019-05-25 First layout
    [node.kicad_pcb, node.sch]
2019-05-25 PCB with batteries
    [node.kicad_pcb, node.sch]
2019-05-25 PCB with batteries on JST PH
    [node.kicad_pcb, node.sch]
2019-05-26 Battery connector on the other side
    [node.kicad_pcb, node.sch]
2019-05-27 Connect RFM69 reset to STM32
    [node.kicad_pcb, node.sch]
2019-05-28 Change to RFM69HW
    [humidity.ods, node.kicad_pcb, node.sch]
2019-05-28 Added RFM69W step model
    [node.kicad_pcb]
2019-06-03 Added battery holder PCB
    [node-batteries.kicad_pcb, node-batteries.sch]
2019-06-03 Moved mounting holes. Slightly narrower PCB
    [node.kicad_pcb, node.sch]
2019-06-03 Move power connector to other side
    [node-batteries.kicad_pcb, node.kicad_pcb, node.sch]
2019-06-03 Adjust mounting holes
    [node-batteries.kicad_pcb, node.kicad_pcb]
2019-06-03 Add resistors as DNP
    [node.kicad_pcb, node.sch]
2019-06-03 Use only resistors to ground to config unit #
    [node.kicad_pcb, node.sch]
2019-06-03 Added missing file
    [node-batteries.kicad_pcb]
2019-06-04 Update SMA connector part number
    [node.sch]
2019-06-07 Changed switch
    [node.kicad_pcb, node.sch]
2019-06-07 Added mounting tabs to battery PCB
    [node-batteries.kicad_pcb]
2019-06-07 Basic gateway schematic
    [gateway.kicad_pcb, gateway.sch]
2019-06-11 Gateway schematic
    [gateway.sch]
2019-06-13 Gateway PCB
    [gateway.kicad_pcb, gateway.sch]
2019-06-13 Added part numbers to node schematic
    [node.kicad_pcb, node.sch]
2019-06-13 Added part numbers to node-batteries
    [node-batteries.sch]
2019-06-13 Started making a BOM
    [humidity.ods]
2019-06-13 Made paths to 3d models relative
    [gateway.kicad_pcb]
2019-06-13 Added some silkscreen
    [gateway.kicad_pcb]
2019-06-15 Added local 3V3 regulator
    [gateway.kicad_pcb, gateway.sch]
2019-06-15 Changed to 22u bul caps
    [node.kicad_pcb, node.sch]
2019-06-18 Layout improvemnets
    [gateway.kicad_pcb, gateway.sch, node-batteries.kicad_pcb, node.kicad_pcb]
2019-06-20 Improved mounting holes and planes
    [gateway.kicad_pcb, gateway.sch, node-batteries.kicad_pcb, node-batteries.sch, node.kicad_pcb, node.sch]
2019-06-23 Improved optional resistors
    [gateway.kicad_pcb, gateway.sch, node.kicad_pcb]
2019-06-24 DS1307 and PTH crystal
    [gateway.kicad_pcb, gateway.sch, node.kicad_pcb, node.sch]
2019-06-24 Minor layout adjustments
    [gateway.kicad_pcb, node-batteries.kicad_pcb, node.kicad_pcb]
2019-06-27 Adjusted CR1216 footprint
    [gateway.kicad_pcb]
2019-06-27 Slight layout adjustments
    [node.kicad_pcb, node.sch]
2019-06-27 Added extra decoupling
    [node.kicad_pcb, node.sch]
2019-06-27 Shortened SPI traces
    [node.kicad_pcb]
2019-06-27 Further cleanup of node PCB
    [node.kicad_pcb]
2019-06-27 Added extra input cap and CS pullup to gateway
    [gateway.kicad_pcb, gateway.sch]
2019-06-27 Improved GND
    [gateway.kicad_pcb]
2019-08-07 Added an extra push button for user input
    [node.kicad_pcb, node.sch]
2019-08-07 Cleaned up schematic
    [node.sch]
2019-08-07 Small udjustments to gateway PCB
    [gateway.kicad_pcb, gateway.sch]
2019-08-07 Adjusted silk screen
    [gateway.kicad_pcb]
2019-08-10 Exchanged pins LEDR (PA0) <-> SW (PA15)
    LEDR is still on TIM2_CH1
    SW is now on WKUP1 and can hence be used to exit the mcu from standby
    [node.sch]
2019-08-11 Removed TODO
    [node.sch]
2019-08-11 Added pulldown to switch
    [node.kicad_pcb]
2019-08-25 Updated date
    [gateway.kicad_pcb, node-batteries.kicad_pcb, node.kicad_pcb]
2019-08-25 Add silkscreen for JLCPCB order number
    [gateway.kicad_pcb, node-batteries.kicad_pcb, node.kicad_pcb]
2019-09-09 Basic software framework for node
2019-09-09 Systick timer
2019-09-11 Added basic SPI driver
2019-09-11 Properly wait before disabling SPI
2019-09-11 Basic SPI Flash API
2019-09-12 Deassert CS pin when done
2019-09-15 Added basic UART API
2019-09-24 Basic I2C driver
2019-09-24 Added missing prototype
2019-09-24 Added timeout to I2C API
2019-09-24 Use spi_read/spi_write for SPI flash
2019-09-25 Basic ADC API
2019-09-26 Clean up SPI driver flag waiting
2019-09-26 Further refactor SPI driver
2019-09-26 Added tests for SPI driver
2019-09-26 SPI driver now passes tests
2019-09-27 Write and read each byte separately in SPI driver
    We wait for RXNE after each byte. This is slower since we are not
    sending the next byte as soon as TXE is set. However, we make sure to
    not miss any bytes by being to slow, which could make us stuck at a
    busy loop. This ensures we are not failing if we receive an interrupt
    somewhere during the transfer, and allows us to use a higher clock frequency.
    [spi.c]
2019-09-27 Introduce named constants for SPI baud rate divider
2019-09-27 SPI flash ultra deep sleep and wakeup
2019-10-05 Basic RFM69 API
    Based on Adafruit's circuitpython driver
2019-10-07 Remove debug printf
2019-10-07 Return proper error codes
    [rfm69.c]
2019-10-10 Added missing prototypes
2019-10-10 Add node address filtering
2019-10-10 Make i2c_register_write buf const
2019-10-10 Use RFM69 interrupt pin
2019-10-12 adc_measure_voltages can fail with a timeout
    [adc.c, adc.h]
2019-10-12 Correct temperature format
2019-10-14 Add timeout to ADC
2019-10-14 Correct temperature bit shift
    [shtc3.c]
2019-10-16 RFM69 HAL for Raspberry Pi
2019-10-16 Added circular buffer in SPI Flash
2019-10-17 Make reading and increasing tail separate steps in SPI flash cbuf
2019-10-28 Set ADC sampling time
2019-10-28 Correct pin name
2019-10-29 Move checksum out of RTC driver
2019-10-29 Factor out pretty printing functions
2019-10-29 Allow uart_*_init to be reetrant
2019-10-29 Clear flags wakeup on reset
    [main.c]
2019-11-03 Loop with blinking on error at startup
    [main.c]
2019-11-03 Use stop mode after failure when sending measurement
    [main.c]
2020-07-05 Keep track of next measurement
2020-07-05 Print RSSI
2020-07-28 Functions for LED on/off
2020-07-28 Pause on boot if button is pressed
2020-07-28 Remove magic constants in UART driver
2020-07-28 Avoid double reads/writes to register
    [main.c]
2020-08-25 Add db support for transactions
    Currently only used in external tests
2020-08-25 Nicer printout of measurements
2020-08-29 Correctly print voltage with two decimal places
    [pretty-print.c]
2020-08-30 Updated BOM
    [humidity.ods]
2020-08-30 Update STM32 cube settings
2020-08-31 Document current package structure
2020-09-01 Use correct printf format for uint64_t
    [package-handler.c]
2020-09-08 Keep track of seen nodes in memory in addition to in DB
2020-09-08 Added mock RFM64 HAL using unix sockets
2020-09-08 Set RFM69 to sleep mode if sending fails
    [main.c]
2020-09-10 Added log about clock drift
    [package-handler.c]
2020-09-10 Initialise latest_fw_hash to avoid warning from gcc
    [package-handler.c]
2020-09-10 Directly use magic numbers in tests
    This ensures that tests fail if the constants are changed by mistake
    [test_package-handler.c]
2020-09-16 Added more tests and caught a bug in handle_ack_or_nack
    [package-handler.c, test_package-handler.c]
2020-09-17 Replace rtc_timestamp with pkg_timestamp
    [package-handler.c, package-handler.h, rtc.c, rtc.h, test_package-handler.c]
2020-09-18 Check that length of cbuf is power of two
2020-09-30 Make SPI flash cbuf base address configurable
2020-10-01 Use BKP3 for SPI flash
2021-02-05 Added missing source file
    [version.c]
